AlanRoybal/photobooth/cloud/share/assets/train.webp

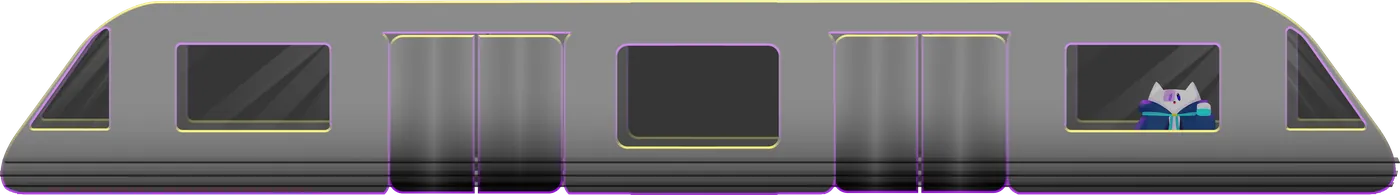
cloud/share/assets/train.webp
