AlanRoybal/photobooth/cloud/share/assets/skyline.webp

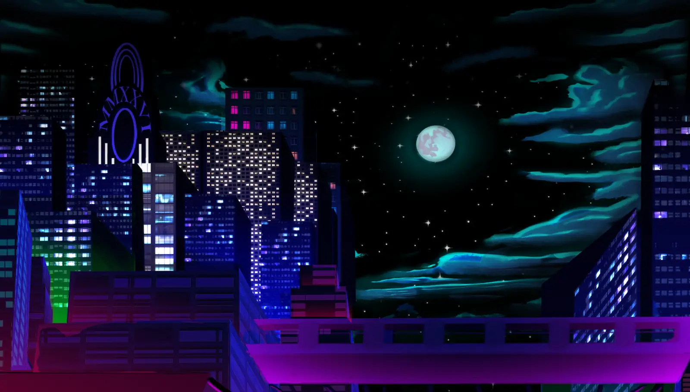
cloud/share/assets/skyline.webp
