AlanRoybal/photobooth/booth/frames/condor-landscape.png

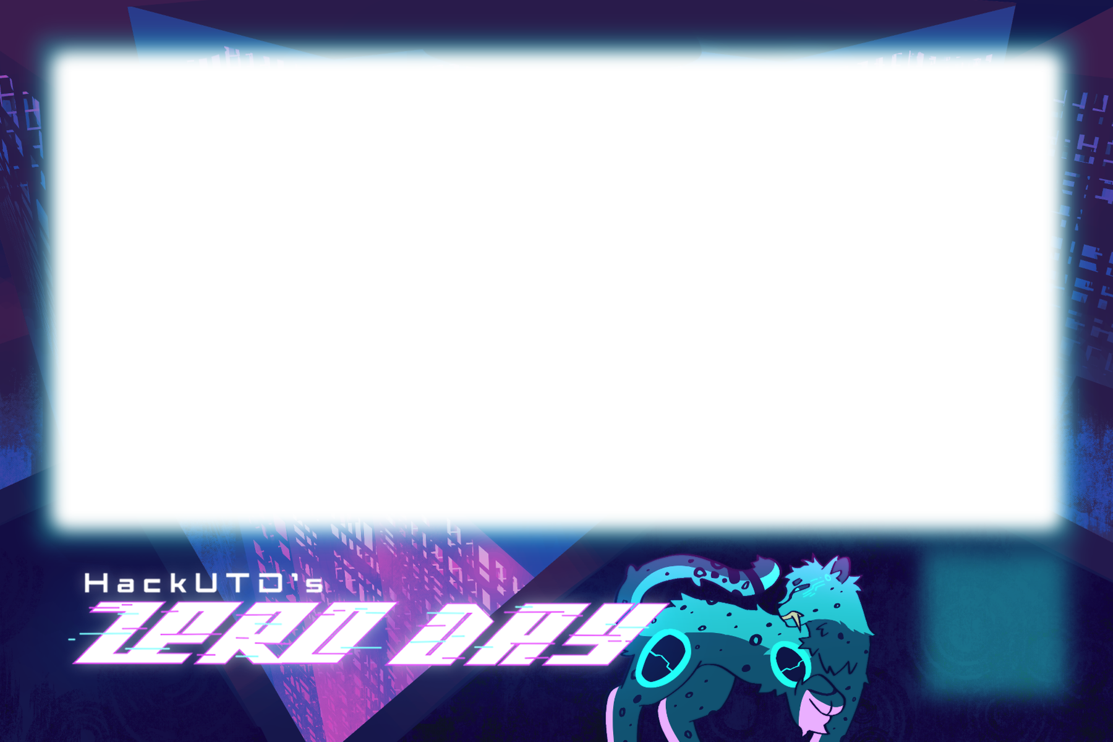
booth/frames/condor-landscape.png
