AlanRoybal/photobooth/booth/frames/condor.png

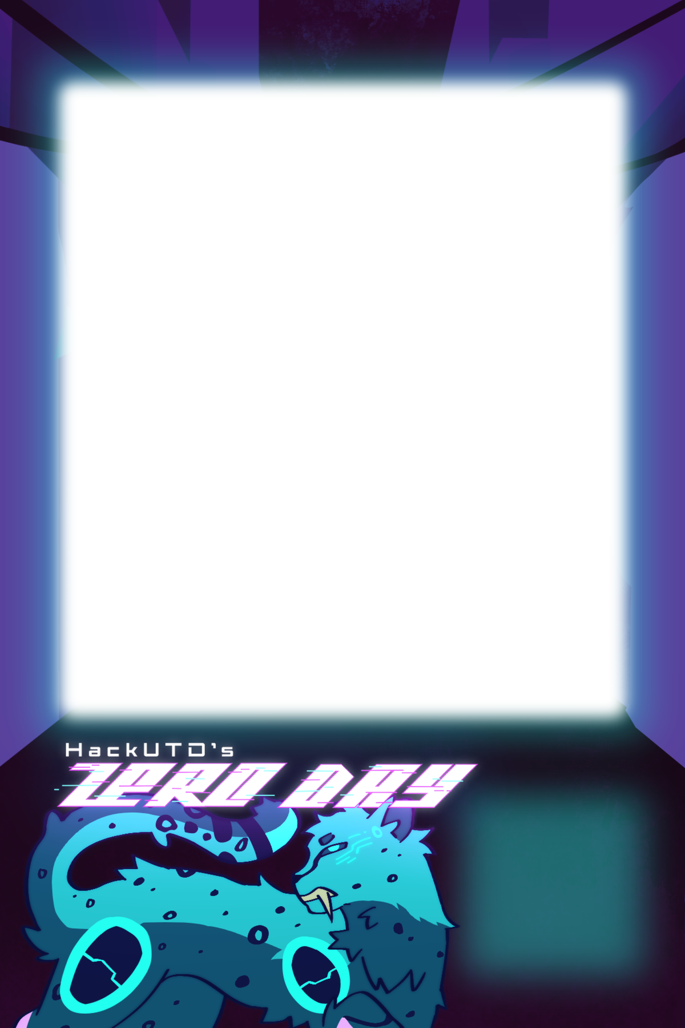
booth/frames/condor.png
