AlanRoybal/photobooth/booth/frames/hyperion.png

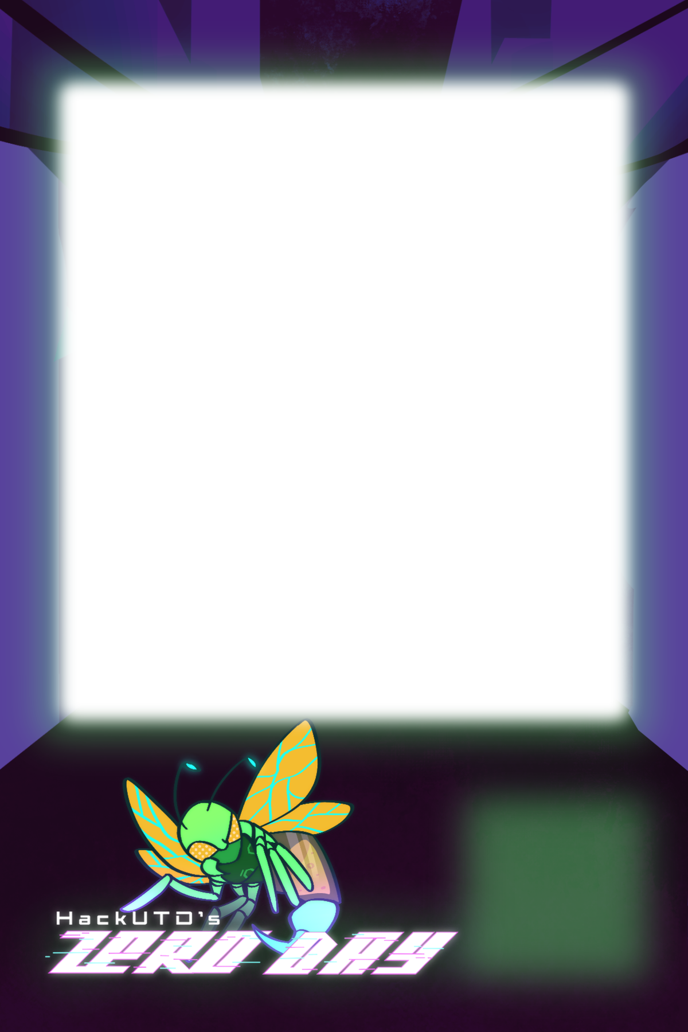
booth/frames/hyperion.png
