AlanRoybal/photobooth/booth/frames/octans-landscape.png

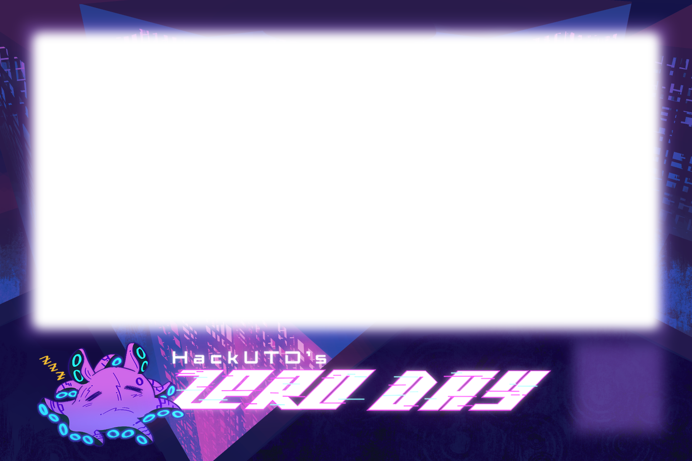
booth/frames/octans-landscape.png
