AlanRoybal/photobooth/booth/frames/poyo-landscape.png

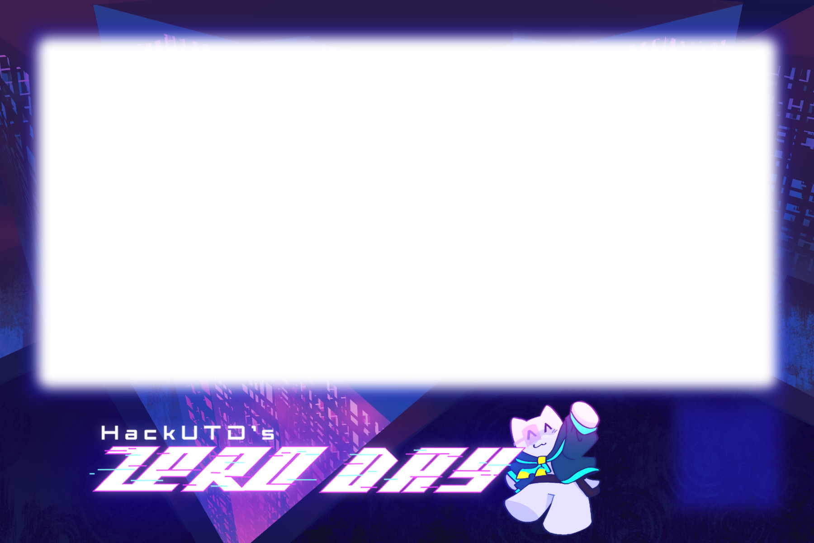
booth/frames/poyo-landscape.png
