AlanRoybal/photobooth/booth/frames/poyo.png

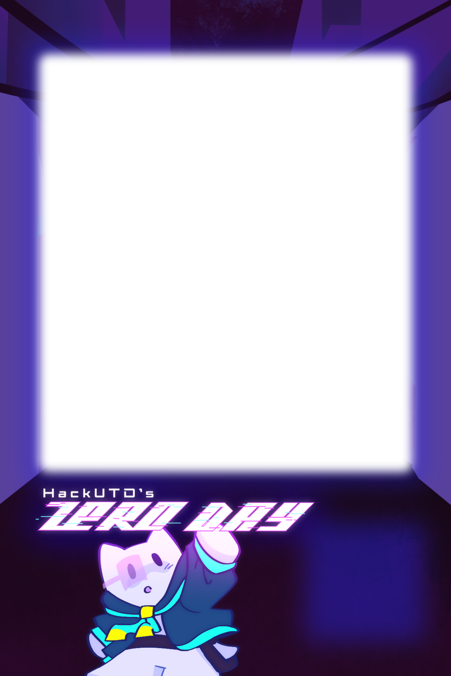
booth/frames/poyo.png
