AlanRoybal/photobooth/booth/frames/remus-landscape.png

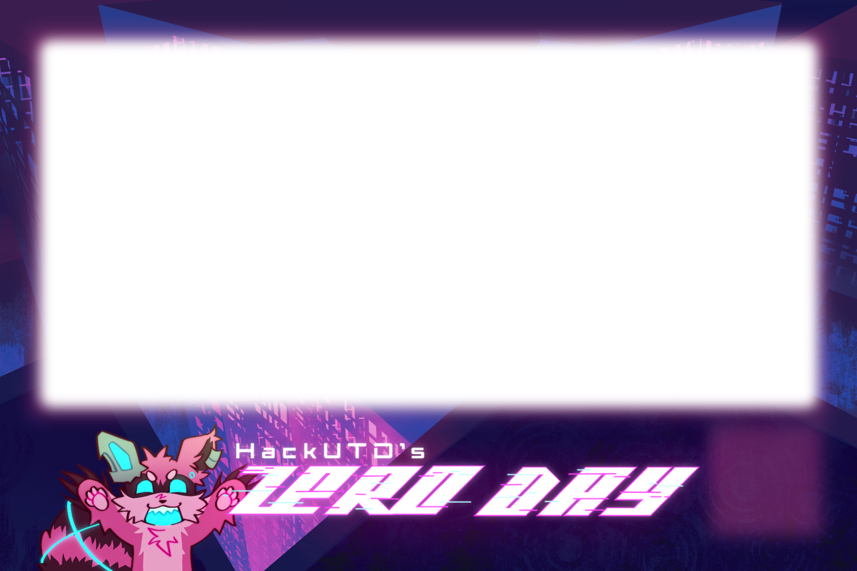
booth/frames/remus-landscape.png
