AlanRoybal/photobooth/booth/frames/remus.png

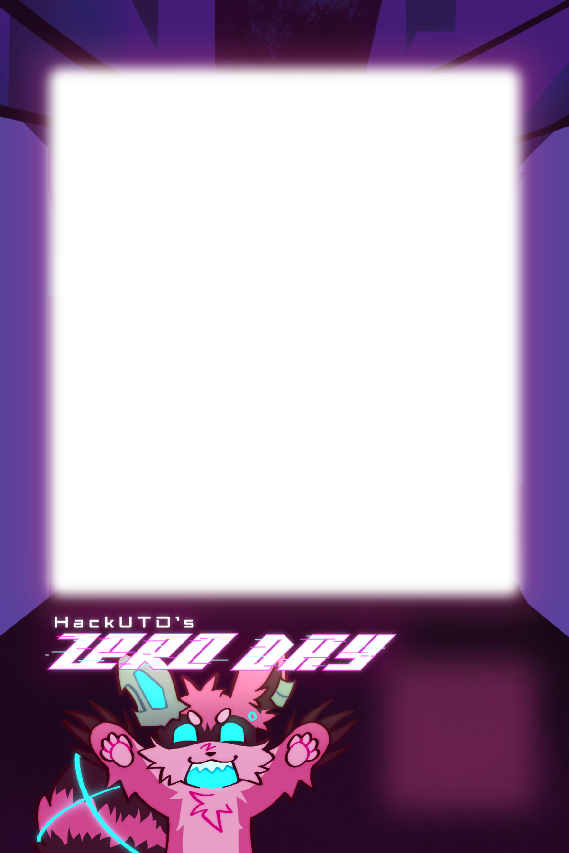
booth/frames/remus.png
