AlanRoybal/photobooth/cloud/share/assets/lineart.webp

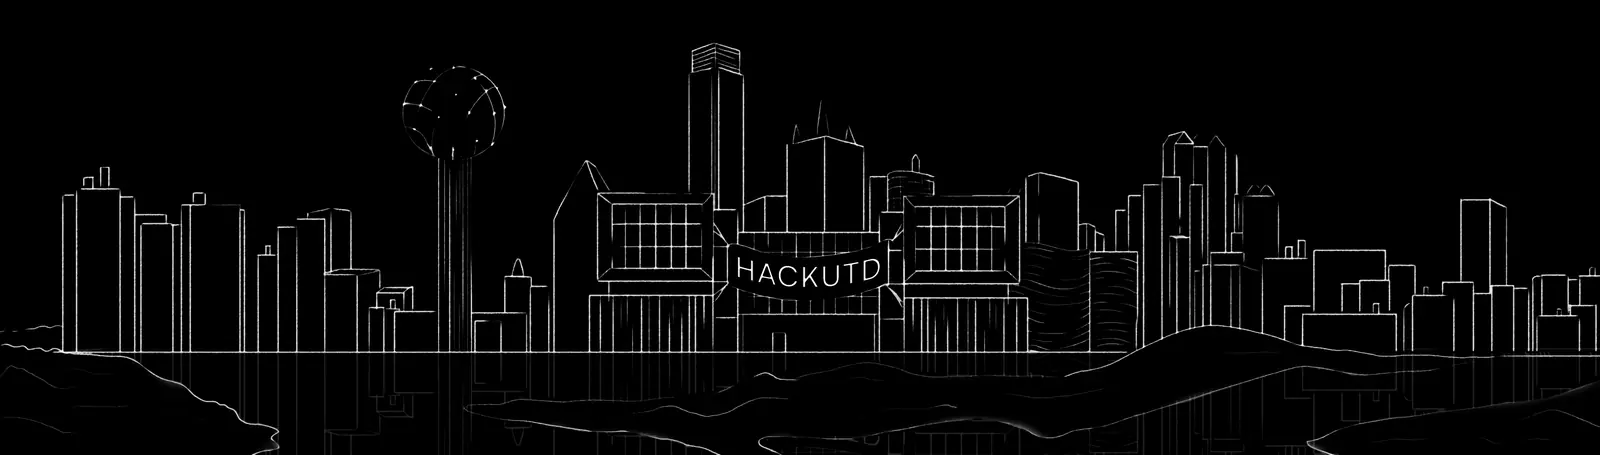
cloud/share/assets/lineart.webp
