AlanRoybal/photobooth/cloud/share/assets/mascots.webp

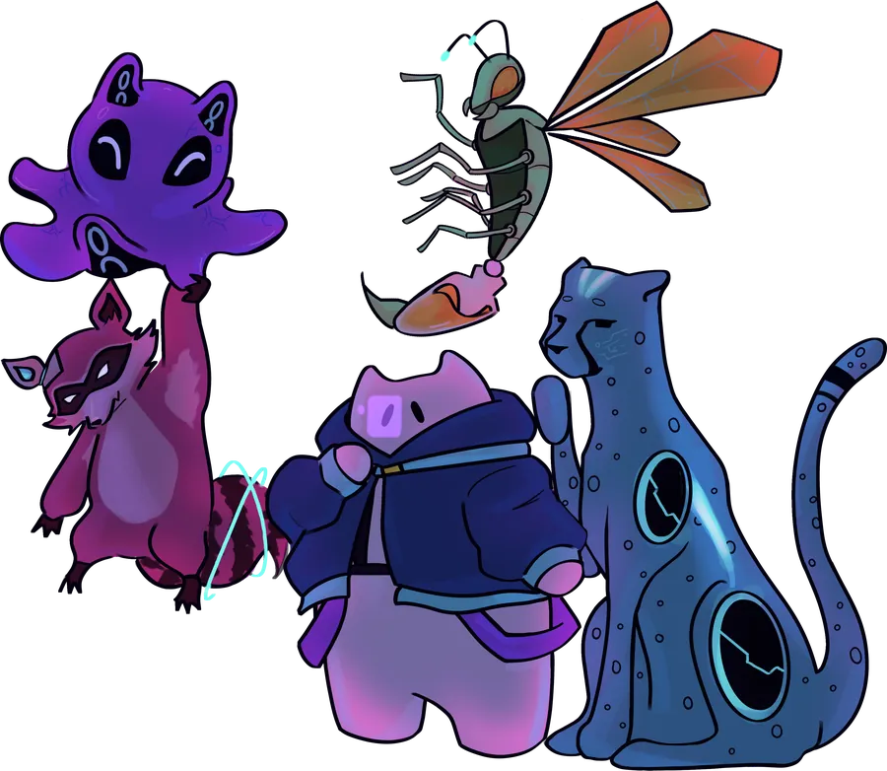
cloud/share/assets/mascots.webp
