AlanRoybal/photobooth/cloud/share/assets/poyo.webp

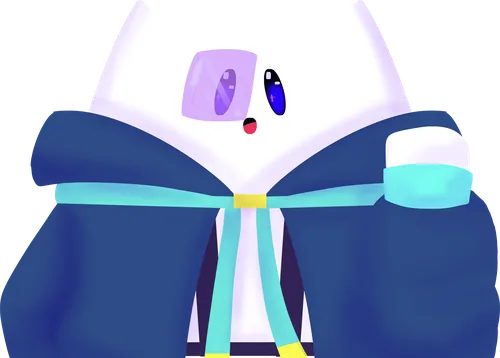
cloud/share/assets/poyo.webp
