AlanRoybal/photobooth/cloud/share/assets/street.webp

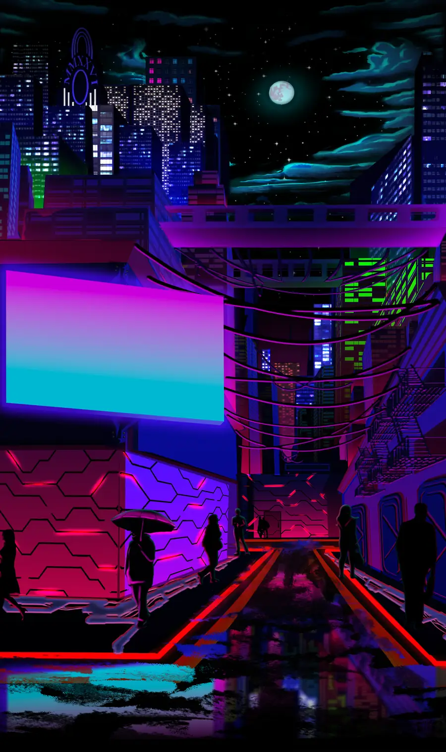
cloud/share/assets/street.webp
