AlanRoybal/photobooth/cloud/share/title.png

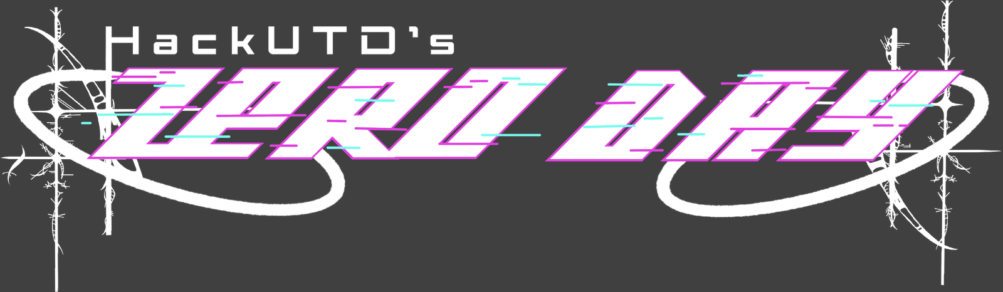
cloud/share/title.png
