AlanRoybal/photobooth/frames-src/templates/home-blank.png

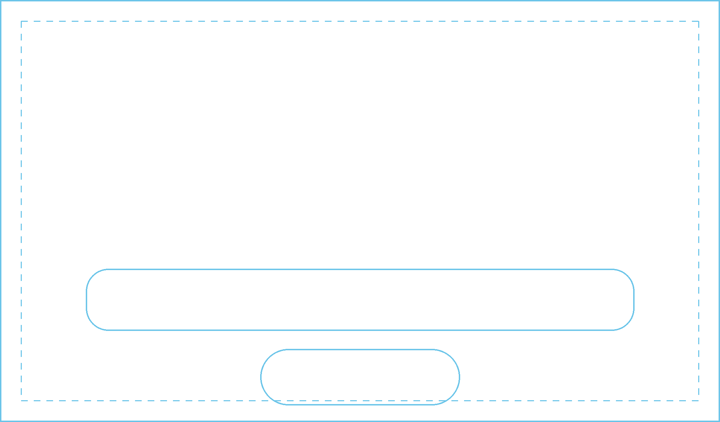
frames-src/templates/home-blank.png
