AlanRoybal/photobooth/frames-src/templates/home-letter-for-drawing.png

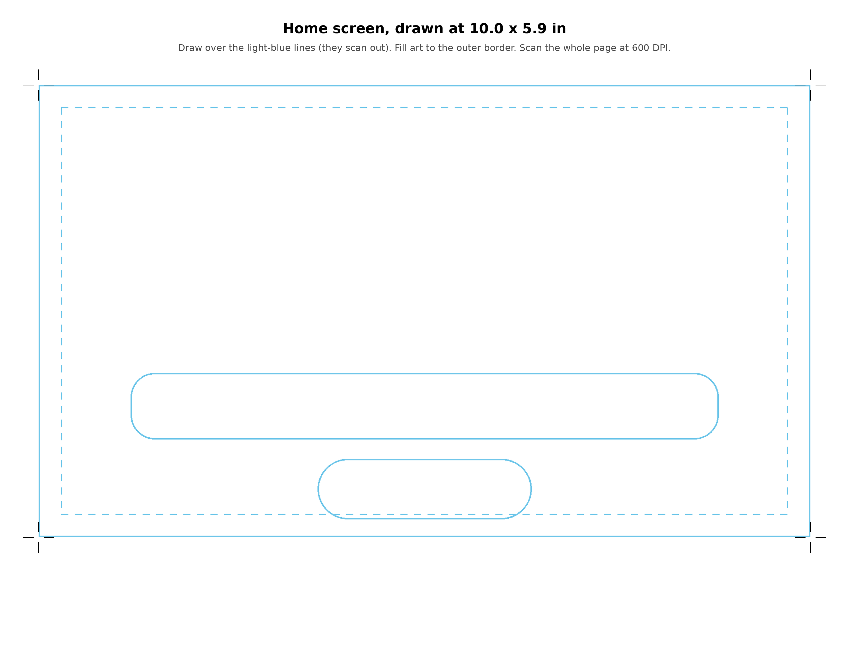
frames-src/templates/home-letter-for-drawing.png
