AlanRoybal/photobooth/frames-src/templates/landscape-blank.png

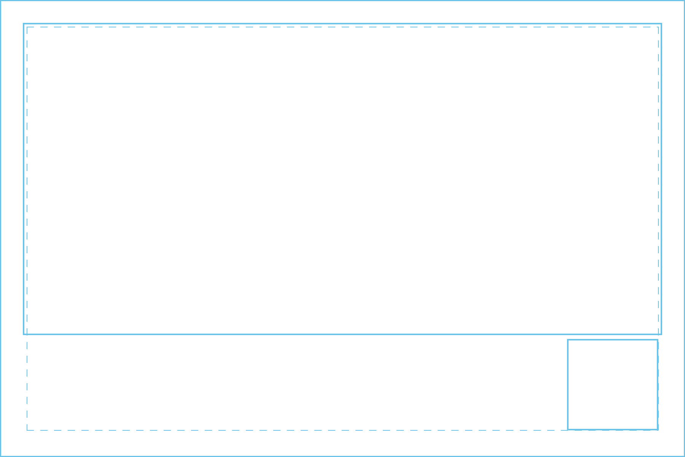
frames-src/templates/landscape-blank.png
