AlanRoybal/photobooth/frames-src/templates/landscape-letter-for-drawing.png

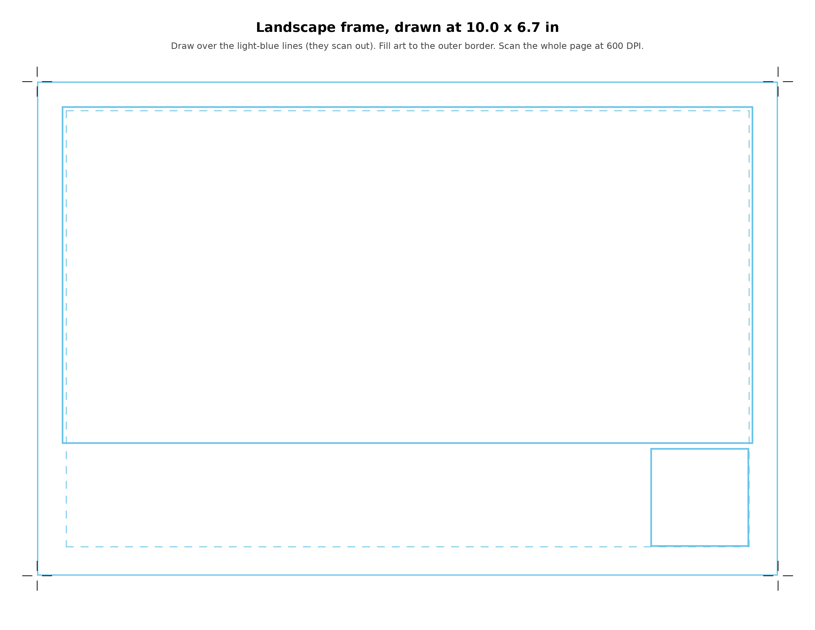
frames-src/templates/landscape-letter-for-drawing.png
