AlanRoybal/photobooth/frames-src/templates/portrait-letter-for-drawing.png

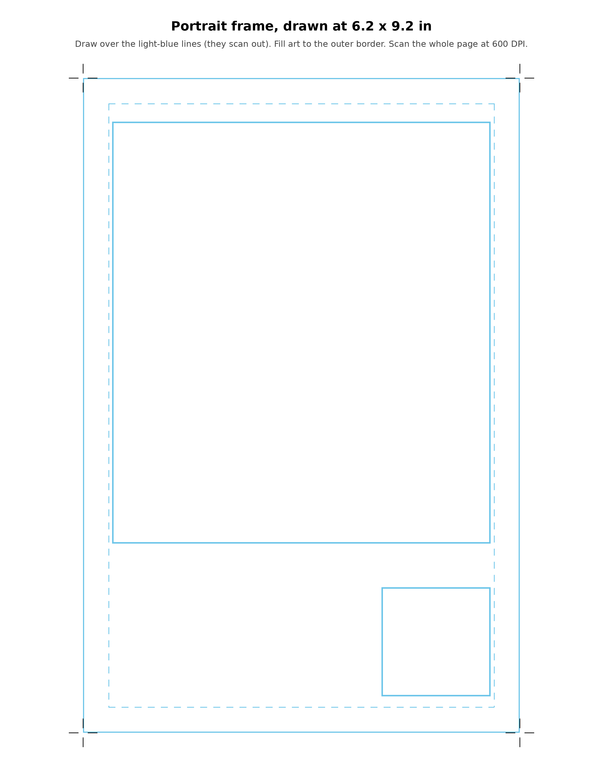
frames-src/templates/portrait-letter-for-drawing.png
