AlanRoybal/photobooth/enclosure/03_screen_retainer_bars_x2__retainer_bar_left.stl

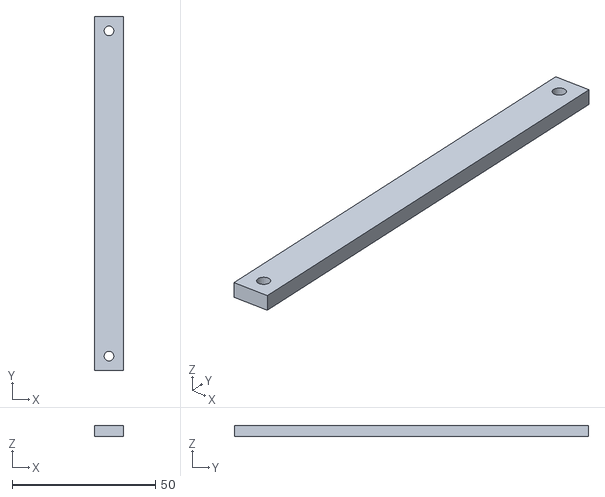
[picture p21: CAD file, 2026-11-06]
enclosure/03_screen_retainer_bars_x2__retainer_bar_left.stl
10.0 x 123.6 x 4.00
