AlanRoybal/photobooth/enclosure/10_rear_paper_tunnel__paper_tunnel.stl

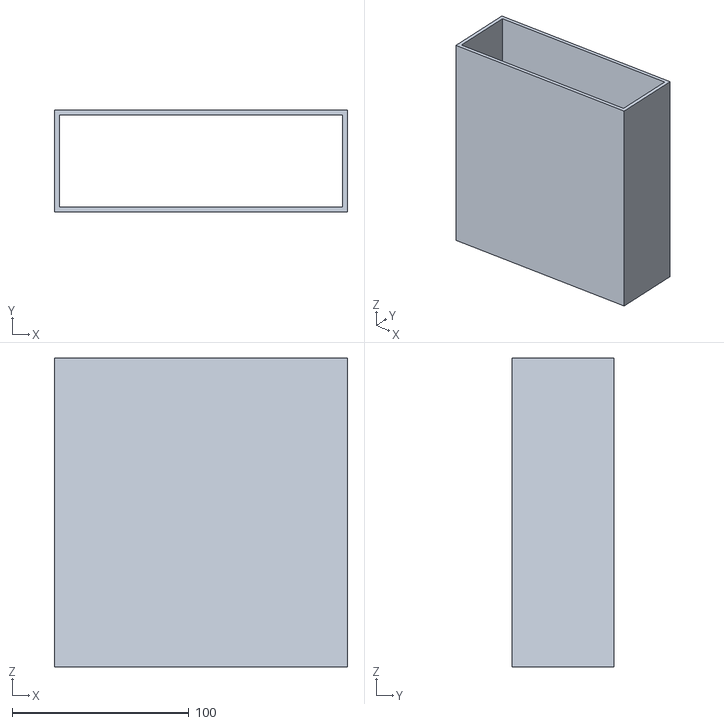
[picture p22: CAD file, 2026-11-06]
enclosure/10_rear_paper_tunnel__paper_tunnel.stl
166.0 x 58.0 x 175.0
