AlanRoybal/photobooth/enclosure/07_ink_door_cover__ink_cover.stl

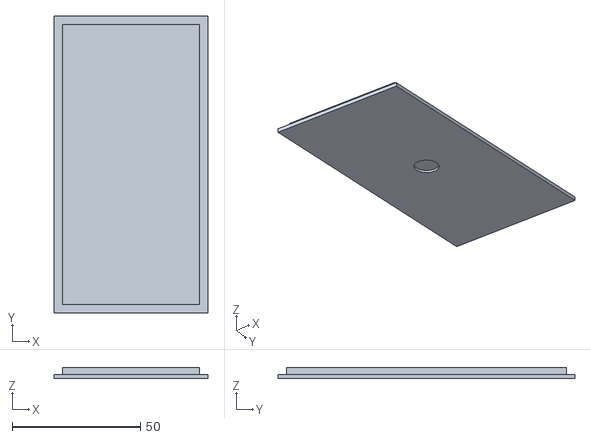
[picture p23: CAD file, 2026-11-06]
enclosure/07_ink_door_cover__ink_cover.stl
60.0 x 116.0 x 4.35
