AlanRoybal/photobooth/enclosure/02_tower_rear_panel.3mf

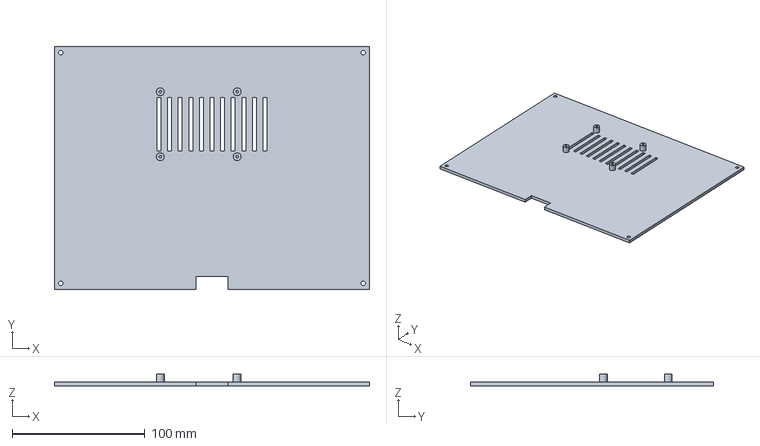
[picture p24: CAD file, 2026-11-06]
enclosure/02_tower_rear_panel.3mf
237.5 x 183.5 x 9.00 mm
