AlanRoybal/photobooth/enclosure/05_base_rear__base_rear.stl

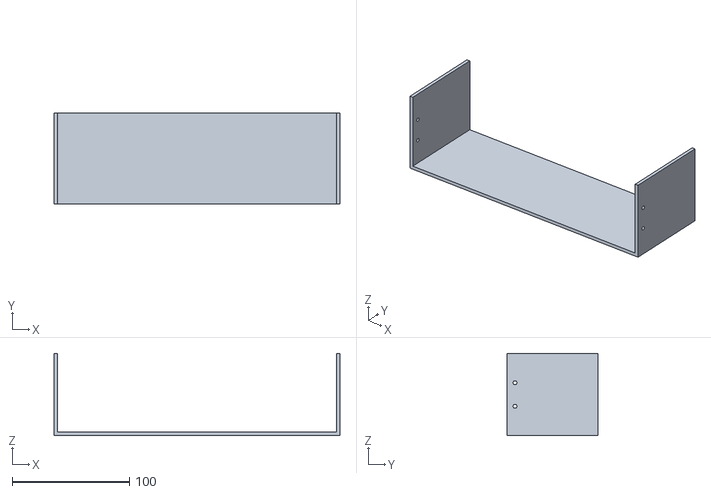
[picture p25: CAD file, 2026-11-06]
enclosure/05_base_rear__base_rear.stl
244.0 x 78.0 x 70.0
