AlanRoybal/photobooth/enclosure/01_tower__tower_cyan.stl

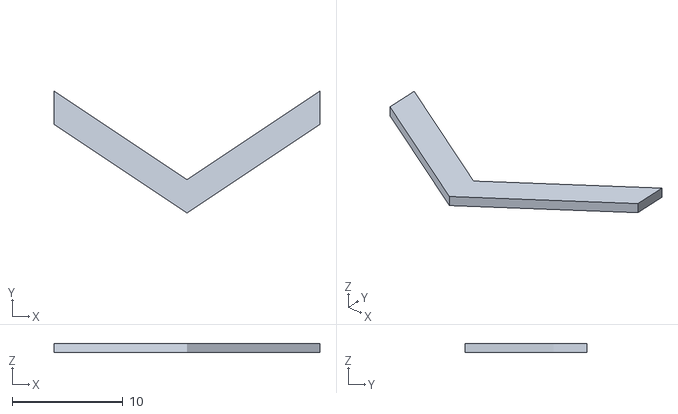
[picture p26: CAD file, 2026-11-06]
enclosure/01_tower__tower_cyan.stl
24.0 x 11.0 x 0.8
