AlanRoybal/photobooth/enclosure/08_crown.3mf

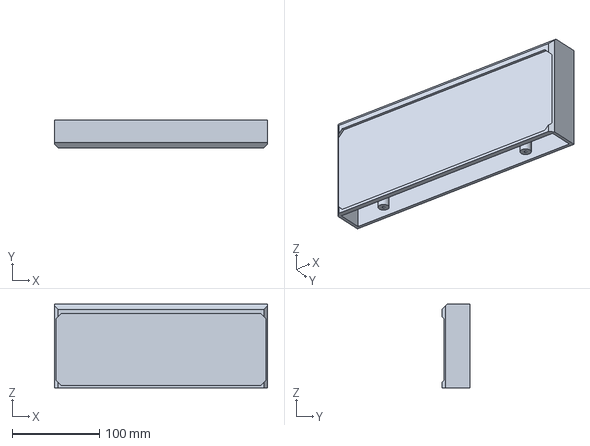
[picture p27: CAD file, 2026-11-06]
enclosure/08_crown.3mf
244.0 x 32.0 x 96.0 mm
