AlanRoybal/photobooth/enclosure/04_base_front.3mf

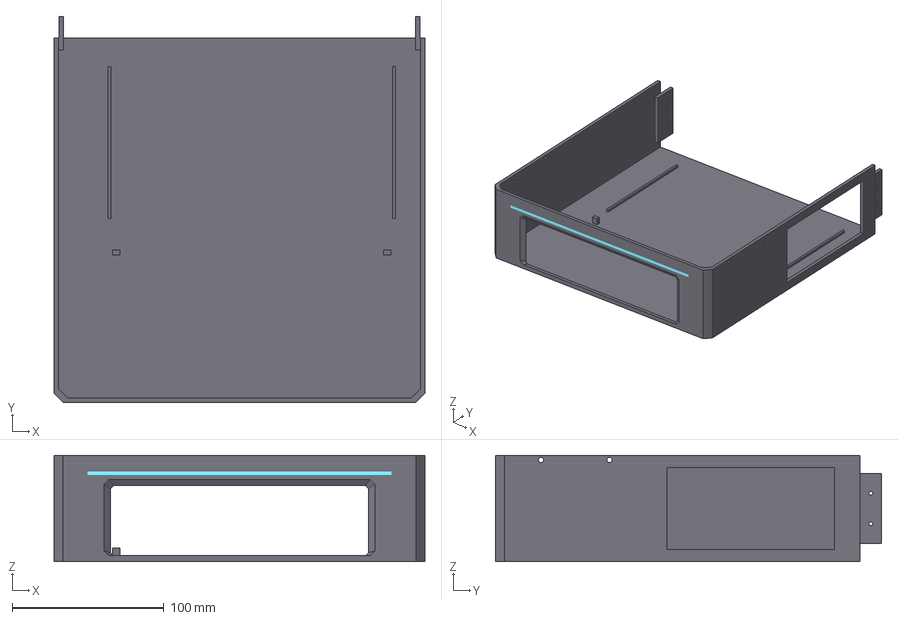
[picture p28: CAD file, 2026-11-06]
enclosure/04_base_front.3mf
244.0 x 254.0 x 70.0 mm
