AlanRoybal/photobooth/enclosure/09_title_sign.3mf

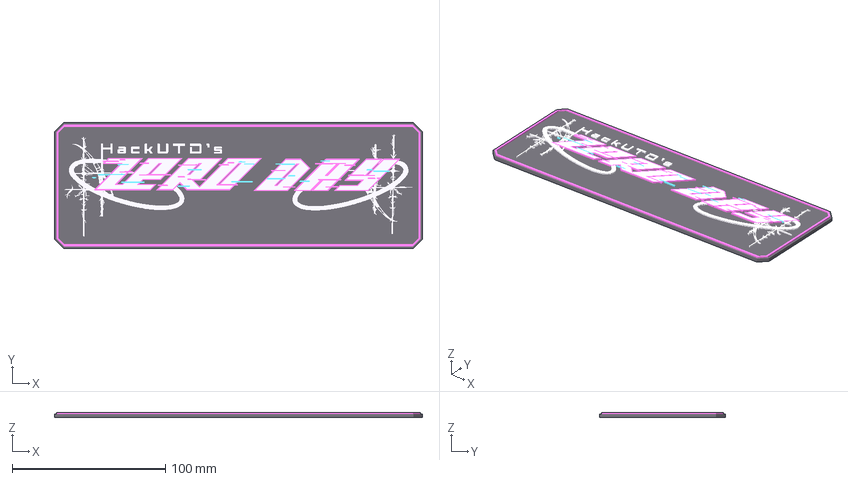
[picture p29: CAD file, 2026-11-06]
enclosure/09_title_sign.3mf
240.0 x 82.0 x 3.49 mm
