AlanRoybal/photobooth/enclosure/04_base_front__base_front.stl

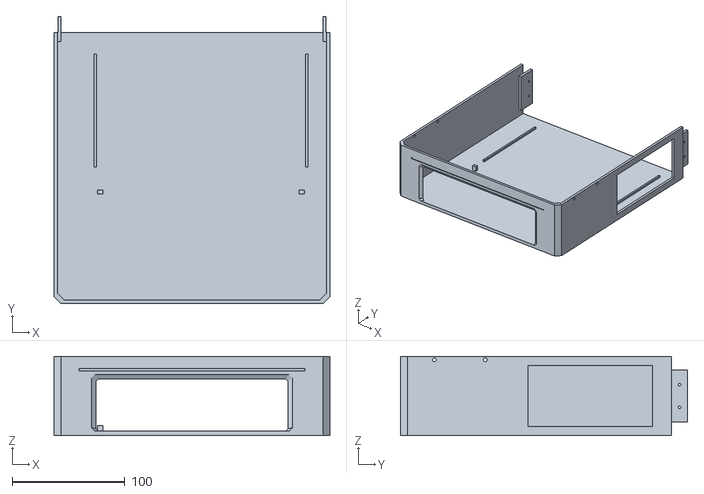
[picture p30: CAD file, 2026-11-06]
enclosure/04_base_front__base_front.stl
244.0 x 254.0 x 70.0
