AlanRoybal/photobooth/enclosure/01_tower__tower.stl

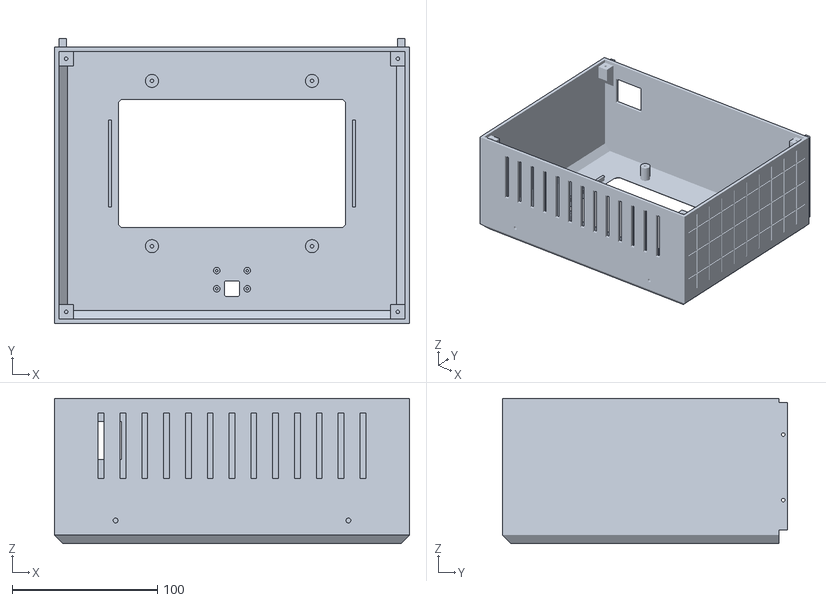
[picture p31: CAD file, 2026-11-06]
enclosure/01_tower__tower.stl
244.0 x 196.0 x 100.0
