AlanRoybal/photobooth/enclosure/01_tower__tower_magenta.stl

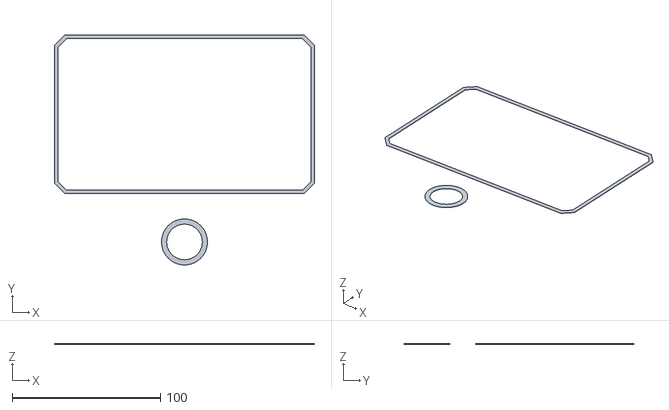
[picture p32: CAD file, 2026-11-06]
enclosure/01_tower__tower_magenta.stl
175.2 x 155.0 x 0.8
