AlanRoybal/photobooth/enclosure/06_lid__lid.stl

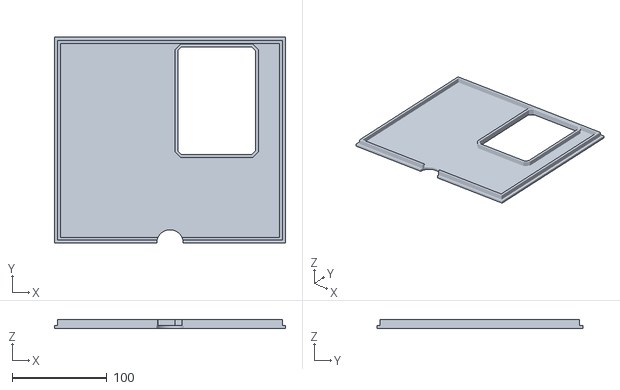
[picture p33: CAD file, 2026-11-06]
enclosure/06_lid__lid.stl
244.0 x 217.8 x 9.00
