AlanRoybal/photobooth/enclosure/09_title_sign__sign_white.stl

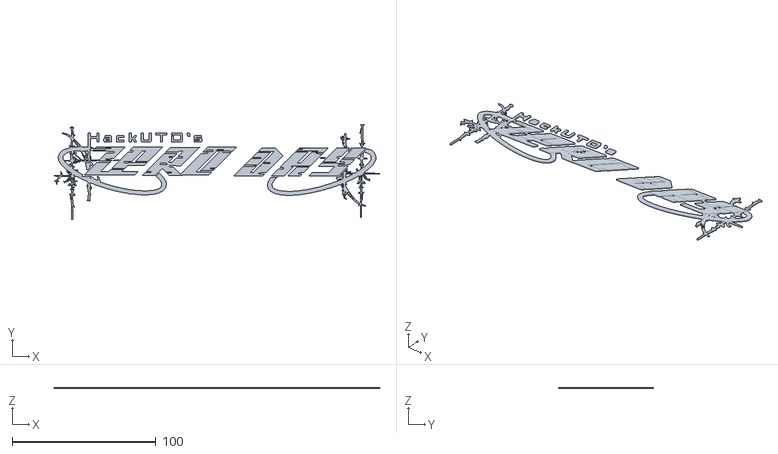
[picture p34: CAD file, 2026-11-06]
enclosure/09_title_sign__sign_white.stl
227.2 x 66.4 x 1.00
