AlanRoybal/photobooth/enclosure/09_title_sign__sign_magenta.stl

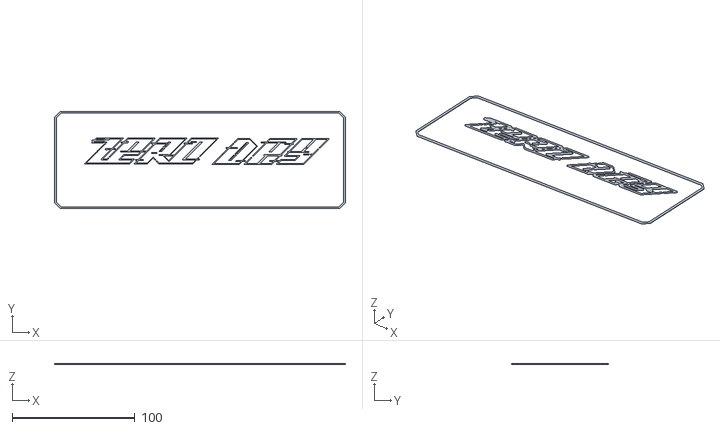
[picture p35: CAD file, 2026-11-06]
enclosure/09_title_sign__sign_magenta.stl
237.5 x 79.5 x 1.00
