AlanRoybal/photobooth/enclosure/09_title_sign__sign.stl

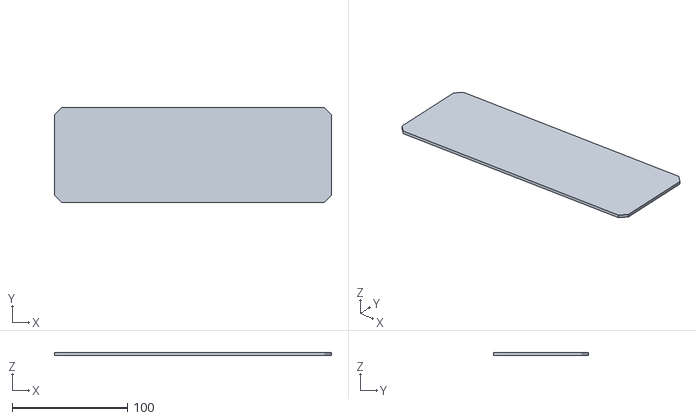
[picture p36: CAD file, 2026-11-06]
enclosure/09_title_sign__sign.stl
240.0 x 82.0 x 2.50
