AlanRoybal/photobooth/enclosure/04_base_front__base_cyan.stl

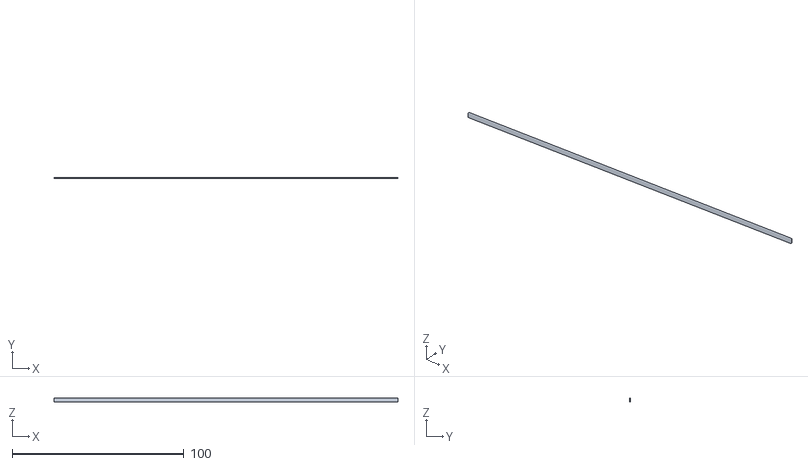
[picture p37: CAD file, 2026-11-06]
enclosure/04_base_front__base_cyan.stl
200.0 x 0.8 x 2.50
