AlanRoybal/photobooth/enclosure/03_screen_retainer_bars_x2.3mf

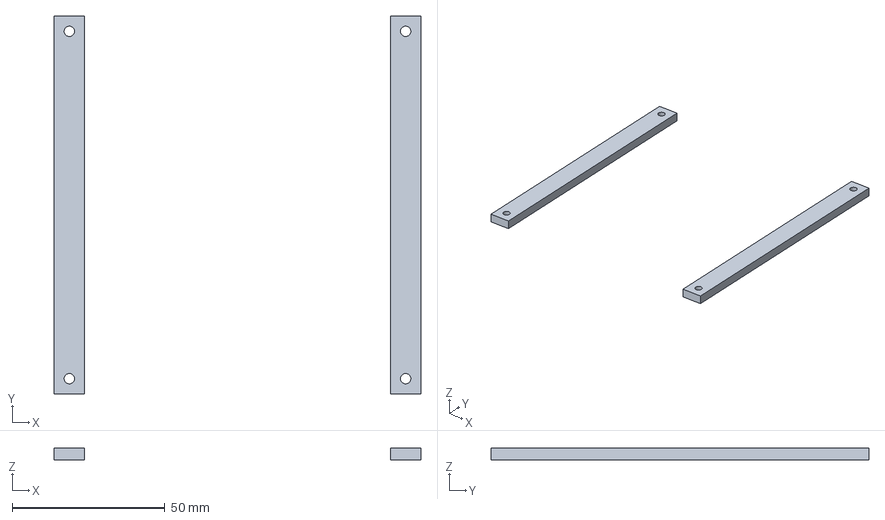
[picture p38: CAD file, 2026-11-06]
enclosure/03_screen_retainer_bars_x2.3mf
120.0 x 123.6 x 4.00 mm
