AlanRoybal/photobooth/enclosure/09_title_sign__sign_cyan.stl

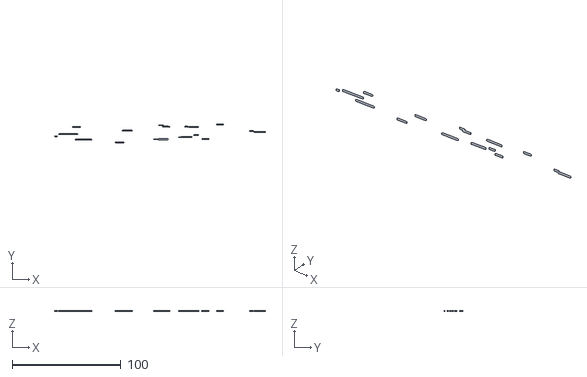
[picture p39: CAD file, 2026-11-06]
enclosure/09_title_sign__sign_cyan.stl
193.9 x 17.4 x 1.00
