AlanRoybal/photobooth/(list of files, cad)

Other CAD files:
enclosure/05_base_rear.3mf
enclosure/10_rear_paper_tunnel.3mf
enclosure/03_screen_retainer_bars_x2__retainer_bar_right.stl
enclosure/08_crown__crown.stl
enclosure/02_tower_rear_panel__tower_rear_panel.stl
enclosure/01_tower.3mf
enclosure/07_ink_door_cover.3mf
enclosure/06_lid.3mf
