AlanRoybal/photobooth/frames-src/templates/home-guide.png

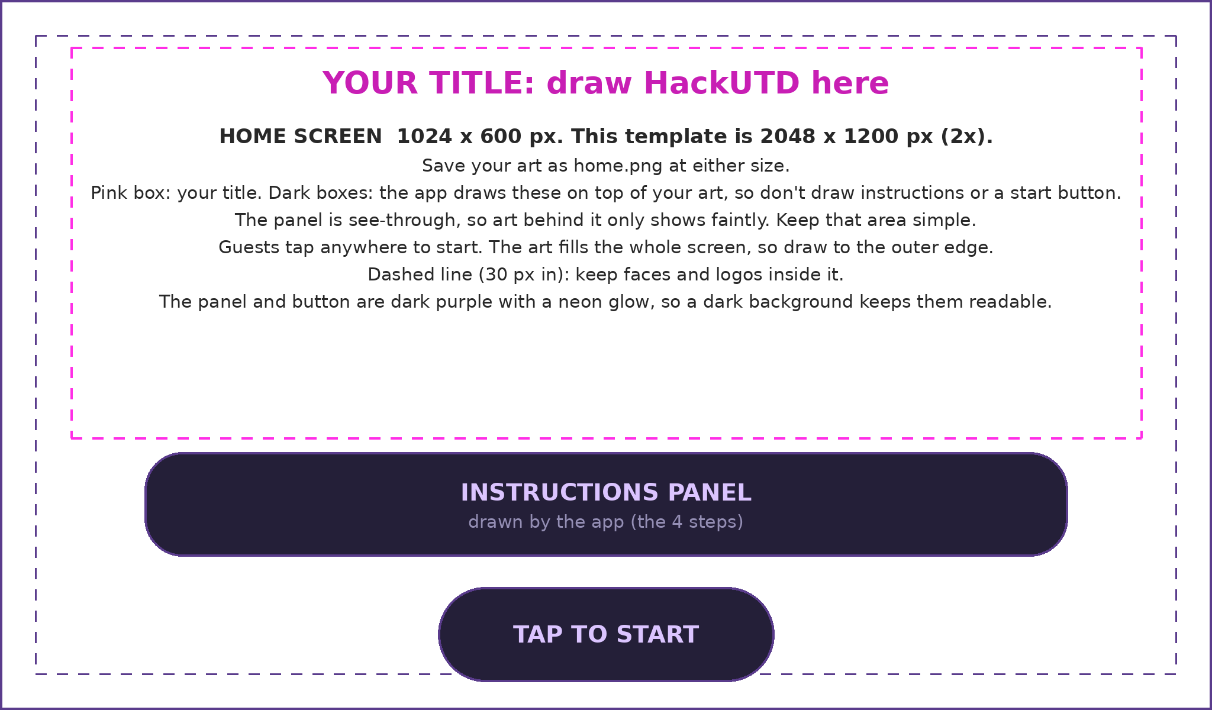
frames-src/templates/home-guide.png
