AlanRoybal/photobooth/frames-src/templates/landscape-guide.png

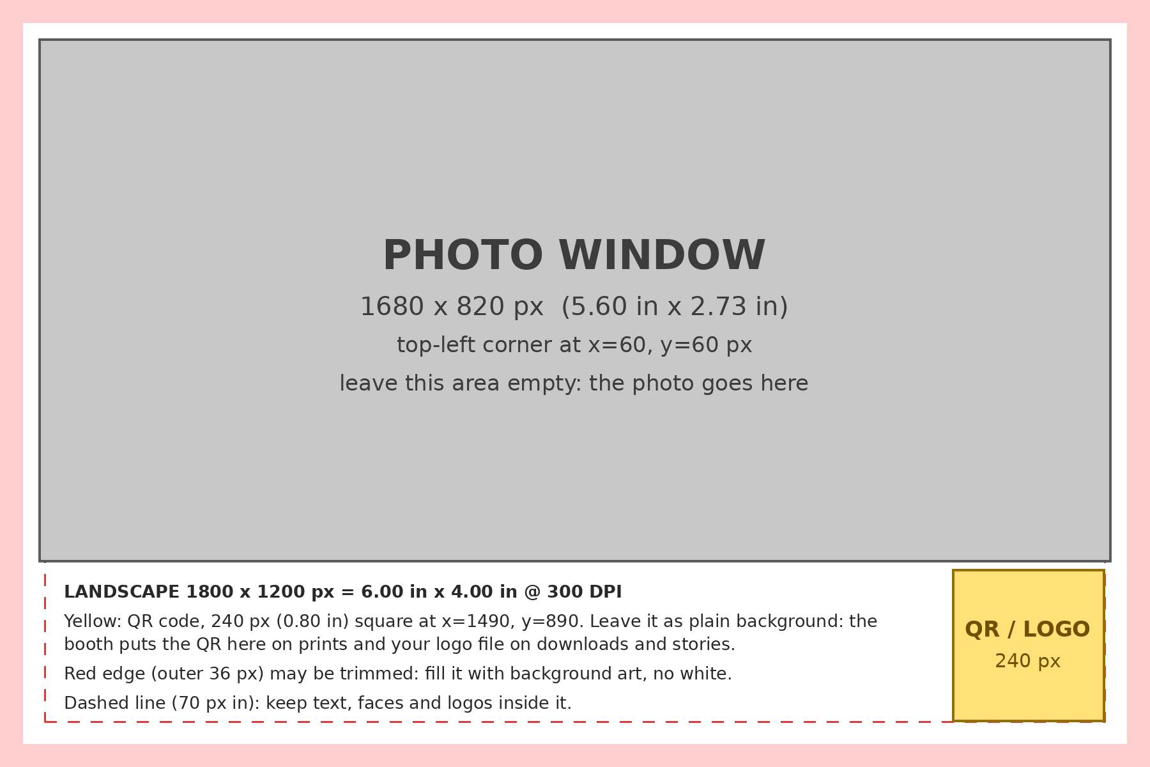
frames-src/templates/landscape-guide.png
