AlanRoybal/photobooth/frames-src/templates/portrait-guide.png

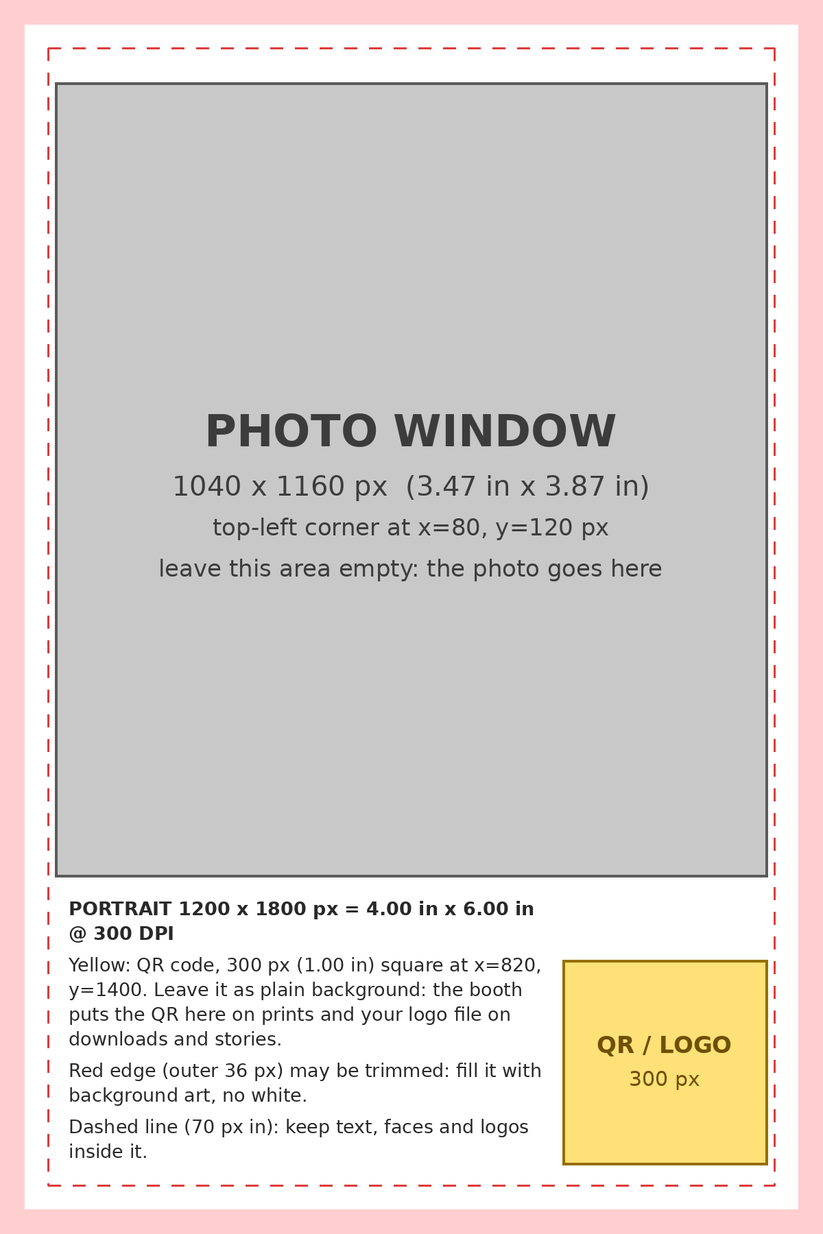
frames-src/templates/portrait-guide.png
