AlanRoybal/photobooth/(commit log)

2026-10-11 Portrait/landscape choice with matching frames and crop guide; copy Instagram handle on share page
2026-10-11 Share page: replace handle copy with 'tag us' line; fix tagline script order
    [app.py]
2026-10-11 Share page: keep Share button visible alongside Download
2026-10-11 Fix QR box outline peeking out past the QR on placeholder frames
    The box was drawn 1px larger than the QR (size+1), leaving a black line on its right and bottom edges in prints.
    Generated with [Devin](https://devin.ai)
2026-10-11 Add print_gamma option to brighten printed copies
    SELPHY dye-sub prints come out darker than the same photo on a phone screen. Applies only to print.jpg; downloads and stories are unchanged.
    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
2026-10-11 Add Cancel button to return to the start screen
    Shown on the instructions, review, and frame picker screens.
    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
2026-10-11 Add camera_ev option and allow longer exposures in dim rooms
    The preview and photos came out much darker than a phone camera indoors. ExposureValue raises auto-exposure; frame time may now stretch to 1/20s so it needs less gain.
    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
2026-10-11 Re-enable the printer queue if CUPS stopped it
    When the SELPHY rejects a job (e.g. it was busy), the ipps backend stops the queue and every later print silently waits forever. Re-enable it before each print so the booth recovers once the printer is power-cycled.
    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
2026-10-11 Add blank design templates for hand-drawn frames
    Guide, blank, overlay, and enlarged Letter-size drawing pages for portrait and landscape, generated from the same layout numbers the booth uses.
    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
2026-10-11 Place a logo file in the QR spot on downloads and stories
    booth/frames/logo.png (or <frame-id>.logo.png for one frame) is fitted into each frame's QR square. Prints still get the QR code over it, so frame art no longer needs a hand-drawn logo there.
    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
    [compose.py]
2026-10-11 Serve share pages and a public gallery from a custom domain
    Adds optional DomainName/HostedZoneId parameters (ACM certificate, API Gateway domain, Route 53 alias). Share pages move to /<id> (old /p/<id> still works), images are served through the API instead of presigned S3 links, and / is a public gallery of every photo, newest first. The Pi now uploads a small thumbnail for the gallery. Also fixes the download filename.
    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
    [app.py, uploader.py]
2026-10-11 Purple QR codes with the HackUTD logo in the center
    New qr_color option, and booth/frames/qr-logo.png is placed in the middle of the QR when present (error correction goes up to H to cover it). The QR encodes the link in uppercase so it fits in compact alphanumeric mode and stays as easy to scan as before; the share page now accepts ids in any case.
    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
    [app.py, compose.py, config.py]
2026-10-12 White logo on downloads/stories, restore cat QR logo, drop LOGO box from sample frames
2026-11-05 Flip and level the UI for an upside-down, slightly tilted screen (#1)
    * Add configurable screen rotation, tilt, offset and scale with calibration grid
    * Replace bezel calibration with a simple screen_rotate_180 flip
    * Add screen_tilt_deg to level the flipped UI
    ---------
    [app.py, config.py]
2026-11-06 Staff menu on the touchscreen: join venue Wi-Fi (password, NetID, sign-in page), printer/upload status, shut down (#3)
2026-11-06 Add the 3D-printed case files (3MF, STL, assembly notes, fit check, 3D viewer) (#4)
    [01_tower.3mf, 01_tower__tower.stl, 01_tower__tower_cyan.stl, 01_tower__tower_magenta.stl, 02_tower_rear_panel.3mf, 02_tower_rear_panel__tower_rear_panel.stl, 03_screen_retainer_bars_x2.3mf, 03_screen_retainer_bars_x2__retainer_bar_left.stl]
2026-11-06 Zero Day mascot frames (poyo, condor, hyperion, octans, remus; portrait + landscape) and home screen art (#5)
2026-11-07 Keep the printing screen up until the SELPHY finishes the print
